Md-Rijwan-Jannat/Spidy-Robot/docs/README.md

# Documentation

Documentation for the Spidy Robot project.

- **build-guide/** - Build guide with photos
- **images/** - Photos and diagrams
- **wiring-guide/** - Wiring instructions
