Md-Rijwan-Jannat/Spidy-Robot/(commit log)

2026-06-23 feat: add site favicon, update logo with icon image, and improve horizontal scroll UX with mouse wheel support and custom scrollbars
2026-06-23 refactor: migrate servo control to PCA9685 driver and update web controller UI with FontAwesome icons and flattened button styles.
2026-06-30 updated the code for servo motor
