Md-Rijwan-Jannat/Spidy-Robot/(notices)

Notices in the files:
README.md:
License: APACHE2.0
